BelaPlatform/bela-pepper/README.md

# PEPPER

Pepper is a DIY solution for integrating Bela with modular and Eurorack synths. [Click here](https://github.com/BelaPlatform/bela-pepper/wiki) for more information.
