BelaPlatform/bela-pepper/Design Files/renders/PCB/pepper-bottom.jpg

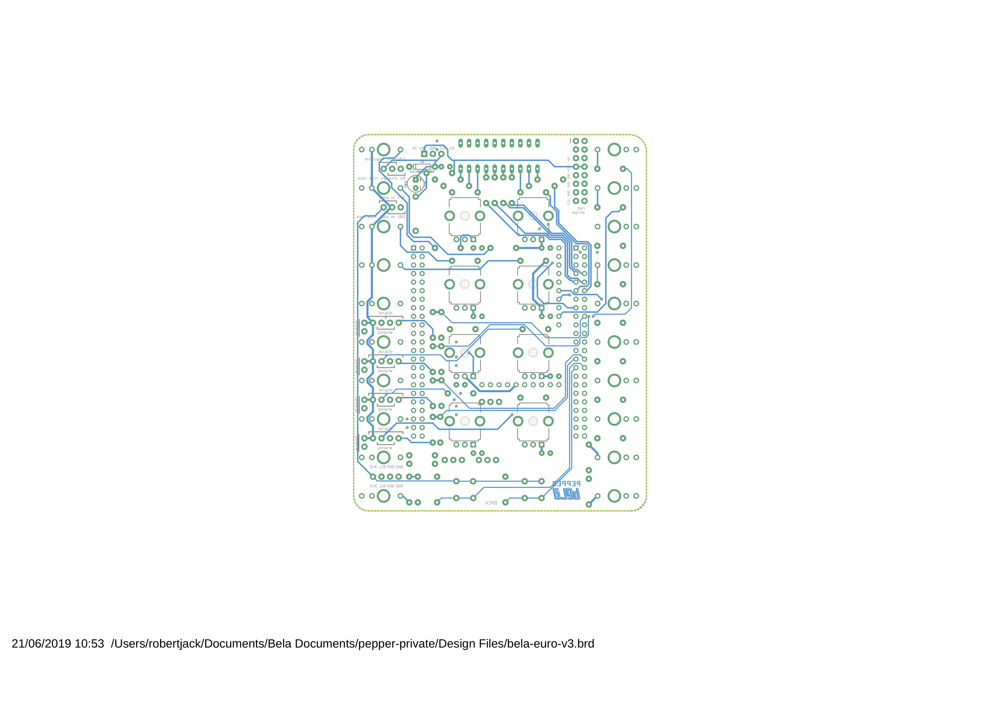
Design Files/renders/PCB/pepper-bottom.jpg
