BelaPlatform/bela-pepper/Design Files/renders/Schematic/pepper-rev2b-schematic.png

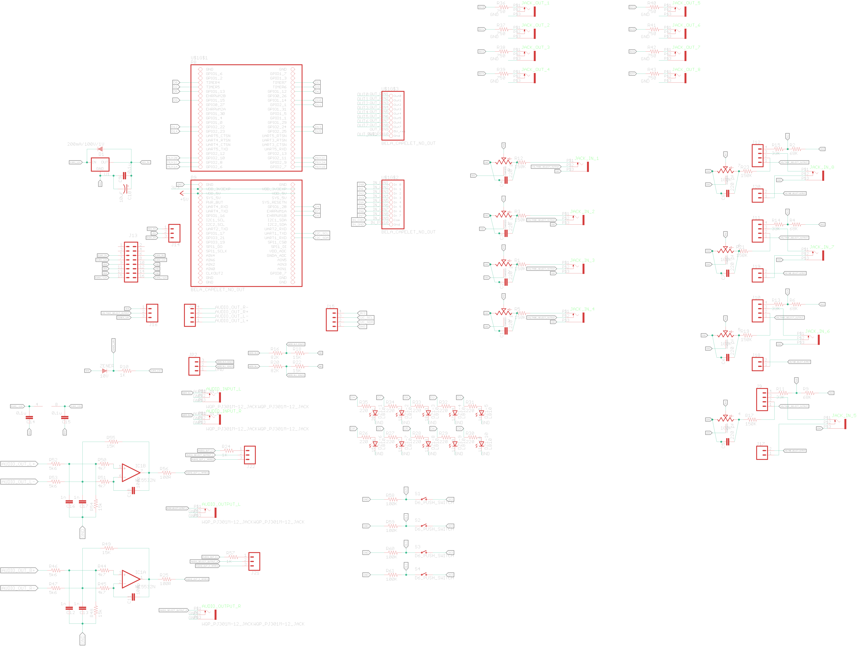
Design Files/renders/Schematic/pepper-rev2b-schematic.png
