BelaPlatform/bela-pepper/Design Files/renders/Schematic/pepper-schematic.jpg

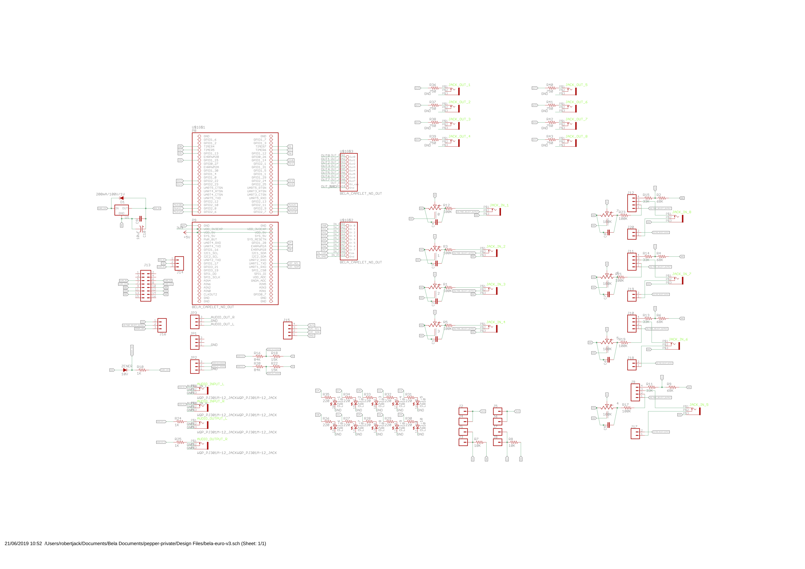
Design Files/renders/Schematic/pepper-schematic.jpg
