BelaPlatform/bela-pepper/(threads)

Thread 1 (2020-03-04):

Pepper build suggestion

ilionic, 2020-03-04:
Recently finished the build but got step 11. wrong - attaching LED bar graph upside down.
That was quite challenging component to desolder and replace ( ended up ordering new one ).
Perhaps worth adding a note for beginners like me to make sure LED bar graph text and cut corner should be facing downwards.
Thanks

giuliomoro, 2020-04-28:
@roberthjack ?

roberthjack, 2020-04-29:
Closed #1.

On Wed, Apr 29, 2020 at 12:34 AM giuliomoro <notifications@github.com>
wrote:

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

bengarland, 2020-07-12:
> That was quite challenging component to desolder and replace ( ended up ordering new one ).

I recently got a Hakko FR-301 desoldering gun and it has been a lifesaver. I thought I'd rarely use it, but it has paid for itself in less than a month. Highly recommended... I can't believe I went so long without one.

ilionic, 2020-07-13:
> I recently got a Hakko FR-301 desoldering gun and it has been a lifesaver. I thought I'd rarely use it, but it has paid for itself in less than a month. Highly recommended... I can't believe I went so long without one.

Nice one, I am pretty sure Hakko doing great job here but need to justify such investment if you are desoldering lots of multi pin components.

Closed 2020-07-31.

Thread 2 (2020-07-12):

Building Rev 2, Step 24 shows erroneous pic?

bengarland, 2020-07-12:
Building Rev 2, Step 24 says "add the female header to the line output to the Bela cape" which should be a 4-pin but the pic shows a 3-pin header. I suggest clarifying this step to say "add the 4-pin female header to the line output to the Bela cape" and show the correct pic.

PS I also added some comments to the BOM, in case it doesn't automatically notify you about it.

Closed 2020-07-31.

Thread 3 (2021-01-02):

Turn off Pepper

FriendlyBalint, 2021-01-02:
If I put Pepper into my eurorack case and I can't push the off button on Bela how can I turn off Bela properly?

giuliomoro, 2021-01-03:
Graceful shutdown of the board is only critical when you have been editing code / building programs. In case of "headless" use, where you don't write to disk, you can just unplug the power from the rack.

Closed 2021-01-03.

Thread 4 (2021-08-10):

USB connection using breakout panel

vsandstrom, 2021-08-10:
In the build kit there is the panel for usb host and device. I thought there would be some easy access solder points or some pins that can be configured as usb on the beaglebone, but I cannot find that info anywhere.

I haven't found any documentation of how to install these ports either, and I am wondering if there is a method or if it is supposed to just be some kind of extension cables.

Anyway, would mean a lot easier access to programming the device when implemented rather than inserting it removing it from the case every time you need to debug a new patch.

roberthjack, 2021-08-10:
There are no solder points as such rather we use standard USB panel mount extension cables with a right angle connector for the board. There are some links as part of the build guide with recommended parts for both the host and device. You can find them here: https://github.com/BelaPlatform/bela-pepper/wiki/Bill-of-Materials#usb-breakout

There are a few different suppliers depending on where you are based. Hope that helps.

Closed 2022-05-25.

Thread 8 (2022-08-13):

Digital In/Out documentation

vsandstrom, 2022-08-13:
I am trying to find somewhere where the segment display and the buttons have their inputs/outputs documented. I am going through the DSP C++ coursework on YouTube and have difficulty using the digital I/O because nothing seems to correspond to what I think it does.

Is there an official documentation of Pepper-specific mapping of digital I/O?

giuliomoro, 2022-08-13:
the pinout of those pins can be found [here](https://github.com/BelaPlatform/bela-pepper/wiki/Pin-numbering)

Closed 2022-08-13.

Thread 10 (2022-09-12):

Connections for Illuminated Buttons

roberthjack, 2022-09-12:
This would be an optional extra if using illuminated LEDs, like in the Befaco DIY kits. The LEDs would be hardwired to the button or to the state of the inputs coming in through the trigger inputs. Extra protection resistor would be necessary between 3v3 and the LEDs.

Thread 9 (2022-09-12):

Switch Power Header for 10-pin

roberthjack, 2022-09-12:
This will require removing the corresponding 5V configuration pin.

giuliomoro, 2023-01-15:
Or leave it 16 pin but ship the correct one

Thread 11 (2022-12-14):

Wiki Schematics and PCB rev2 links are broken

x37v, 2022-12-14:
The links here:

https://github.com/BelaPlatform/bela-pepper/wiki/Schematics-and-PCB

Thread 12 (2023-01-16):

Diagnostics project

roberthjack, 2023-01-16:
Create a project which can be run once the build is complete to test everything is working.

Loop back all outputs to inputs, CV and Audio. Cycle through LEDS. Print reading from buttons. For example of loop back code see the bela cape test: [ ](https://github.com/BelaPlatform/Bela/tree/master/examples/Extras/cape-test)

giuliomoro, 2023-01-16:
Extras/salt-factory-taste could also be useful.
