BelaPlatform/bela-pepper/Design Files/renders/Faceplate/pepper_faceplate_rev2.pdf

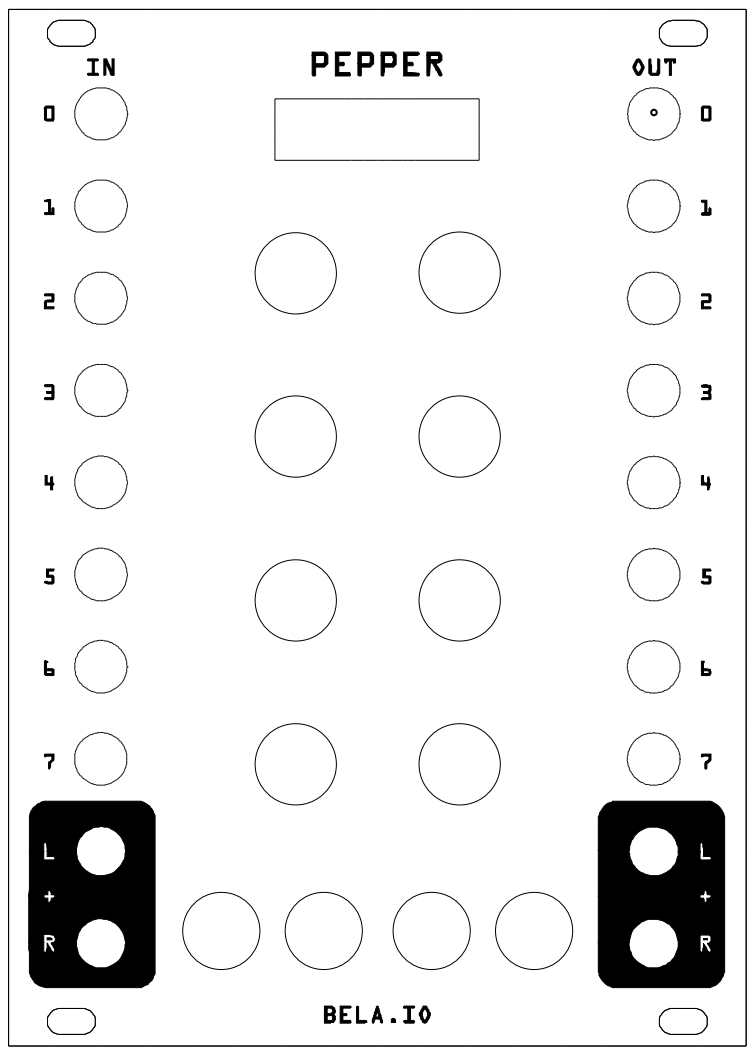
[picture p4: page 1]

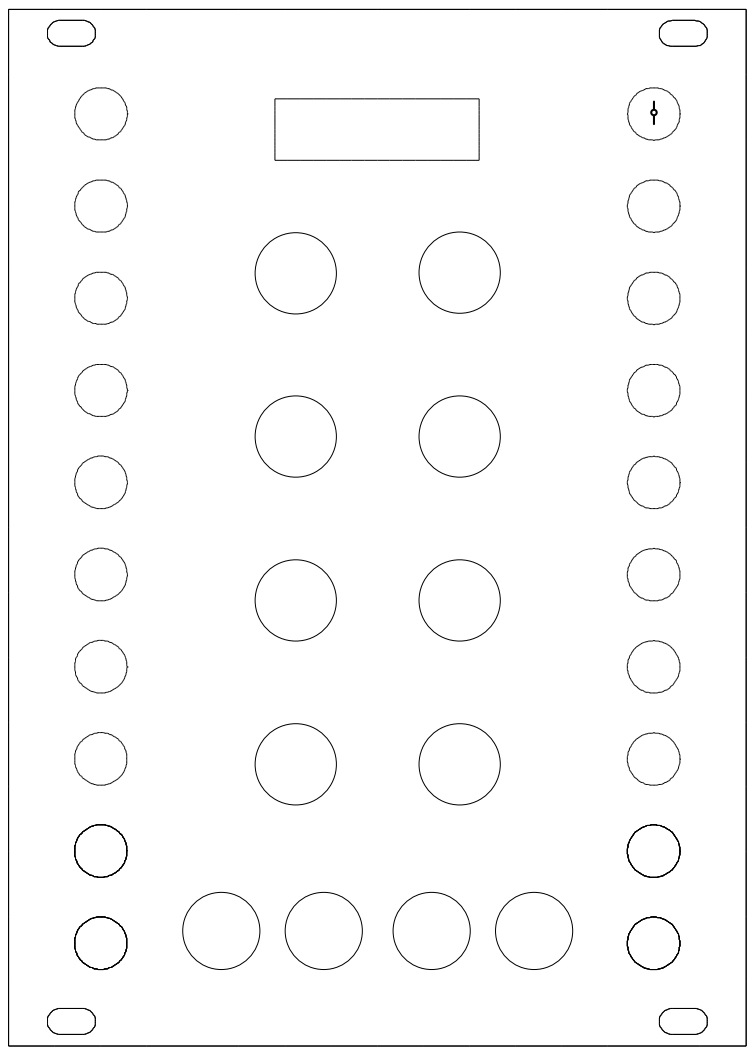
[picture p5: page 2]

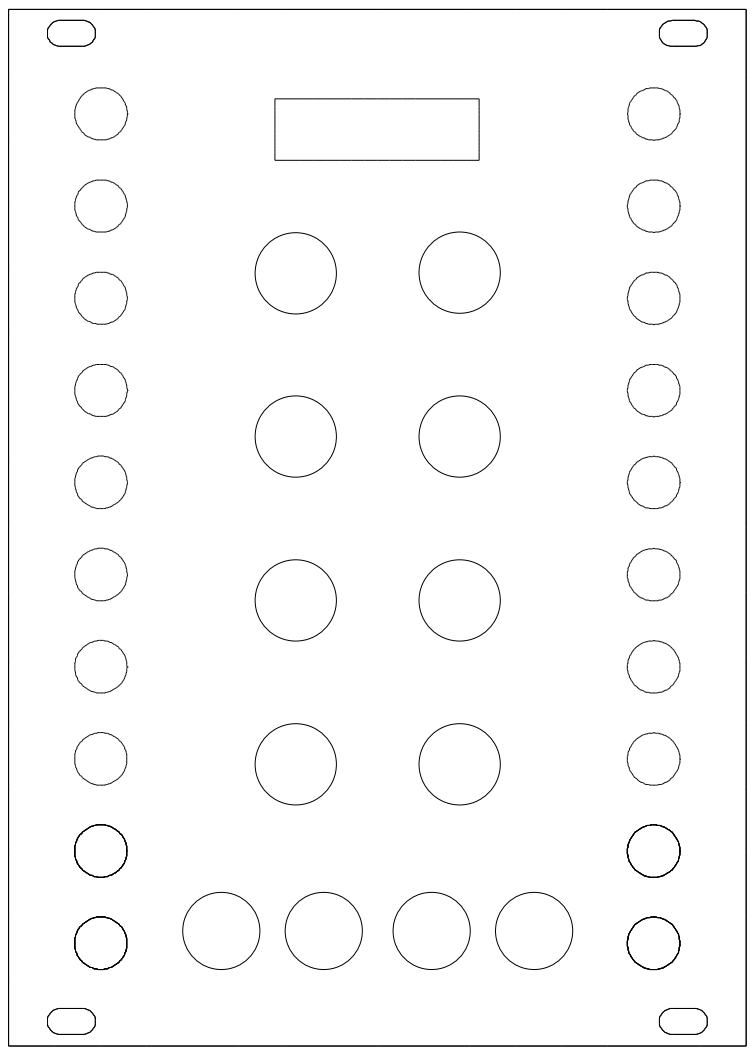
[picture p6: page 3]

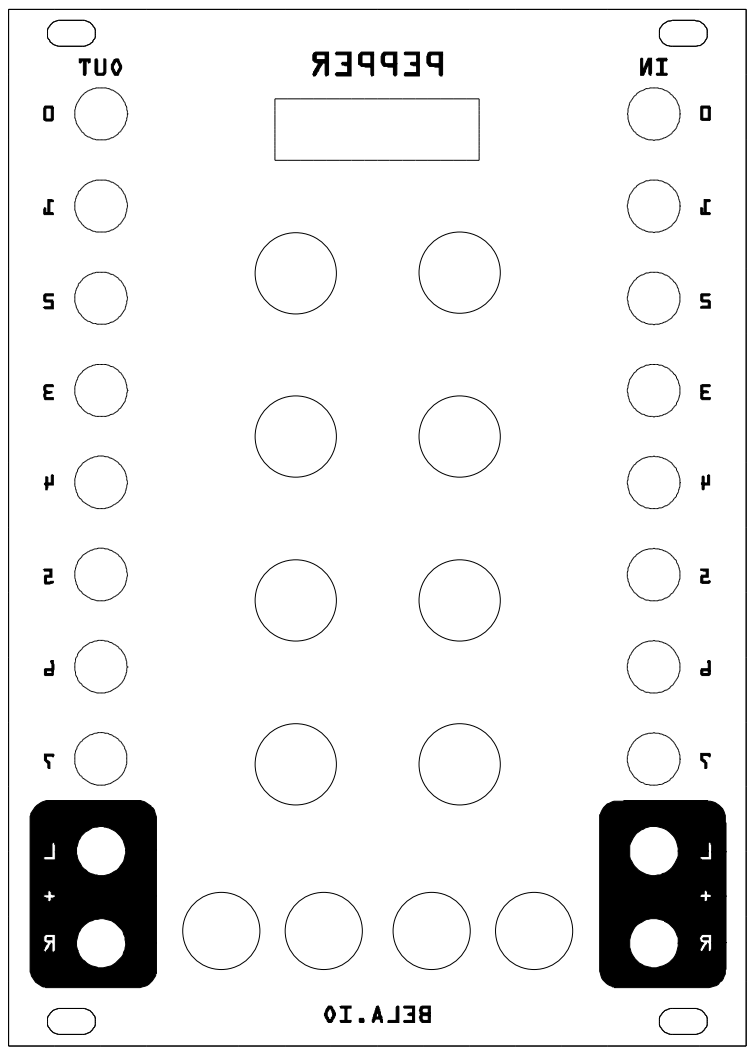
[picture p7: page 6]

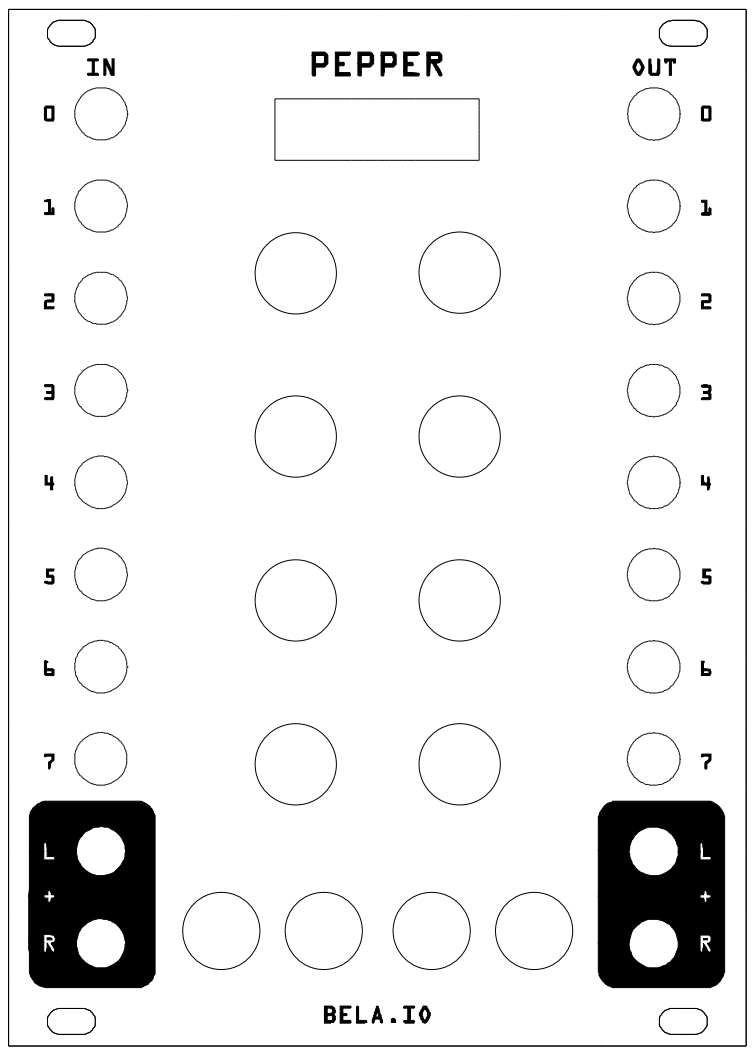
[picture p8: page 7]

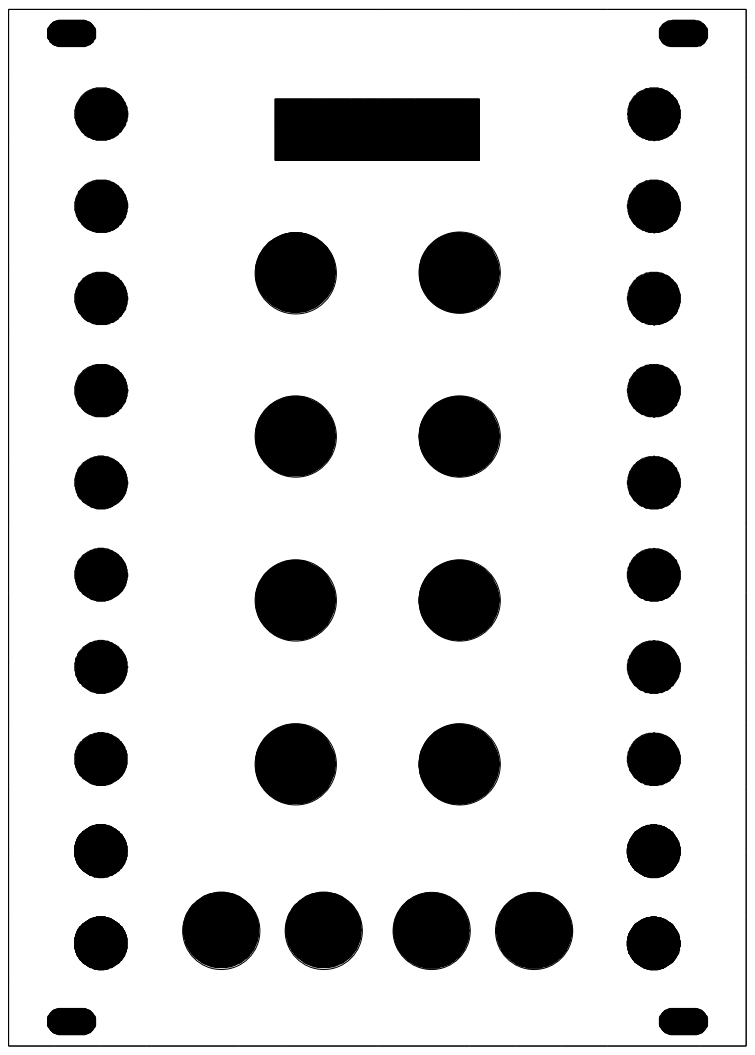
[picture p9: page 8]
