BelaPlatform/bela-pepper/Design Files/renders/PCB/pepper-rev2b.brd.pdf

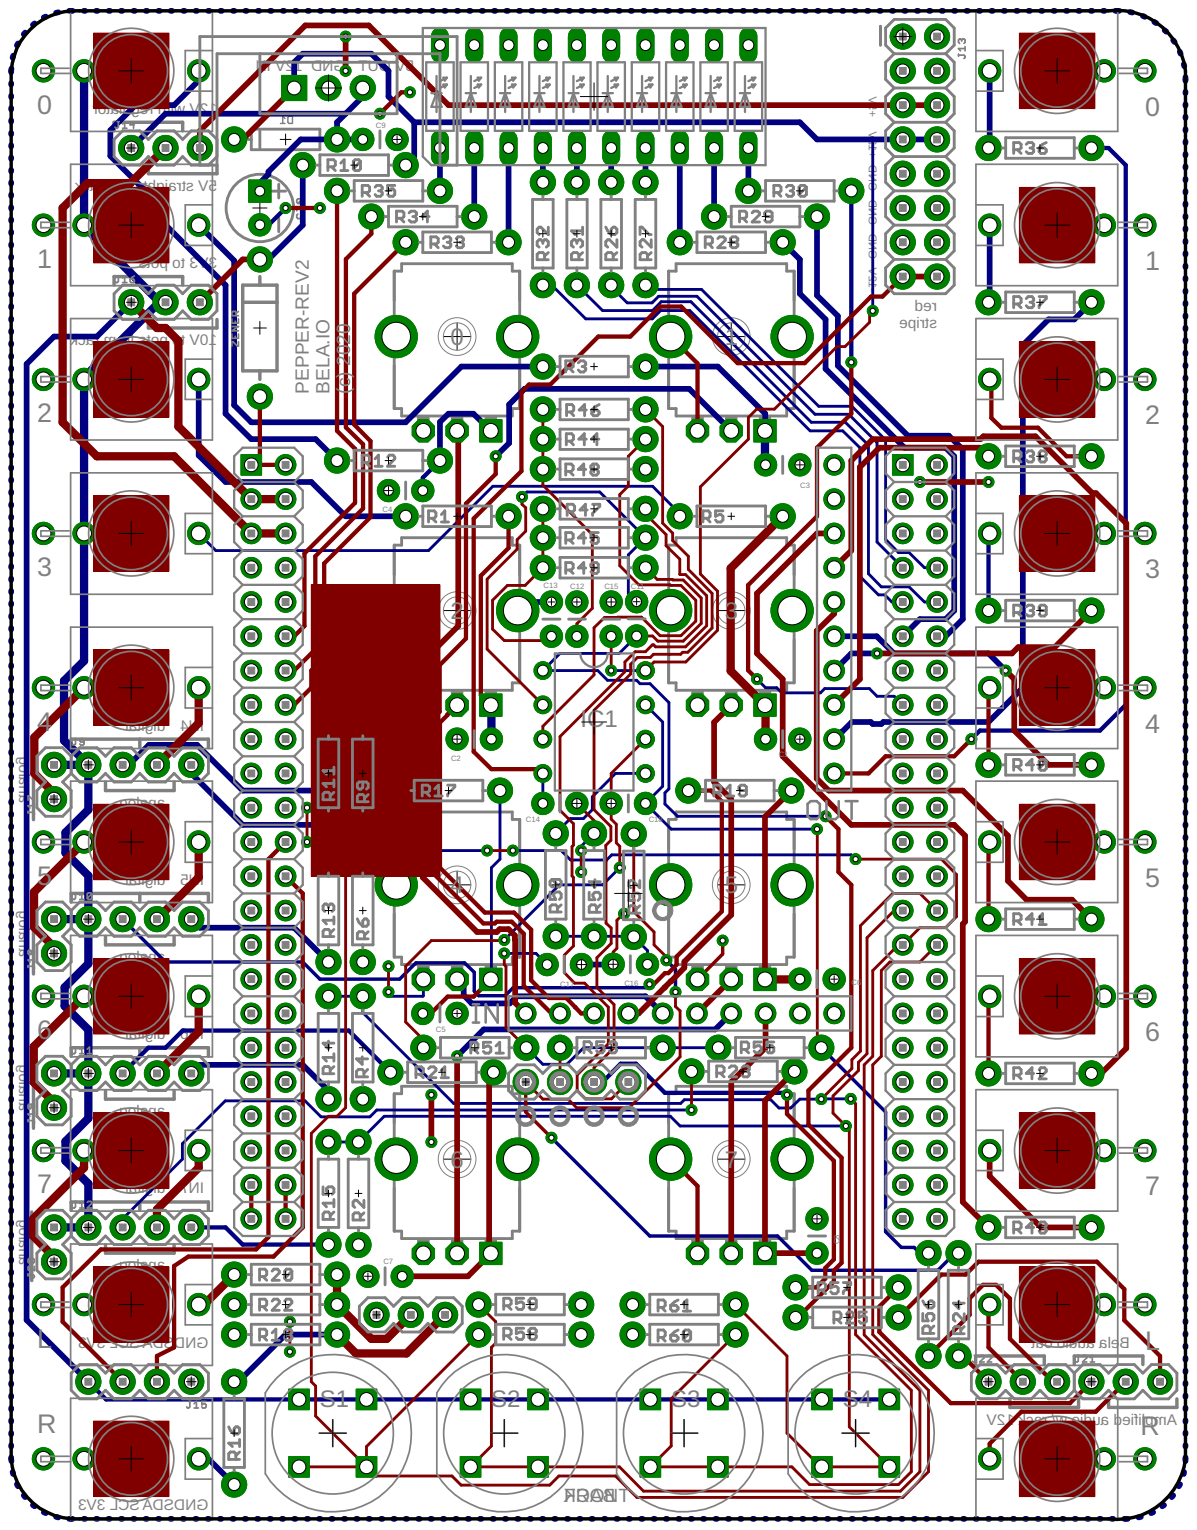
[picture p10: page 1]

analog analog
