BelaPlatform/bela-pepper/Design Files/renders/Faceplate/pepper-faceplate-rev1.pdf

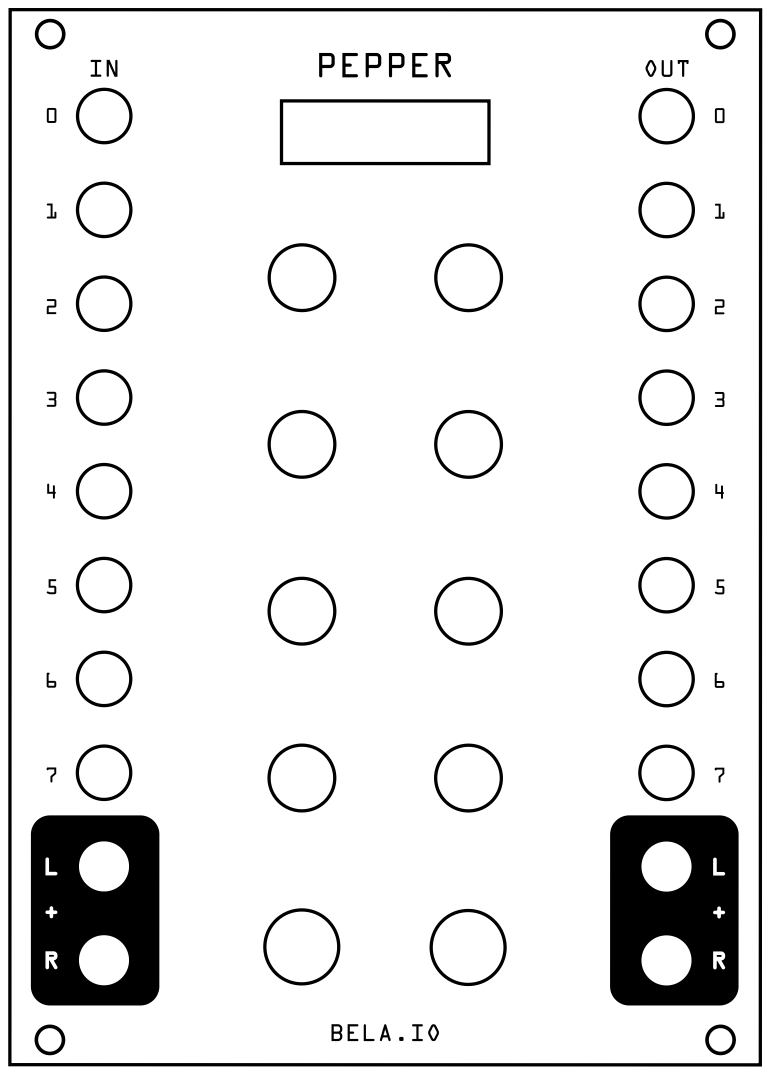
[picture p11: page 1]
