BelaPlatform/bela-pepper/Design Files/rev2/pepper-rev2.brd

## EAGLE design Design Files/rev2/pepper-rev2.brd (2022-09-14)

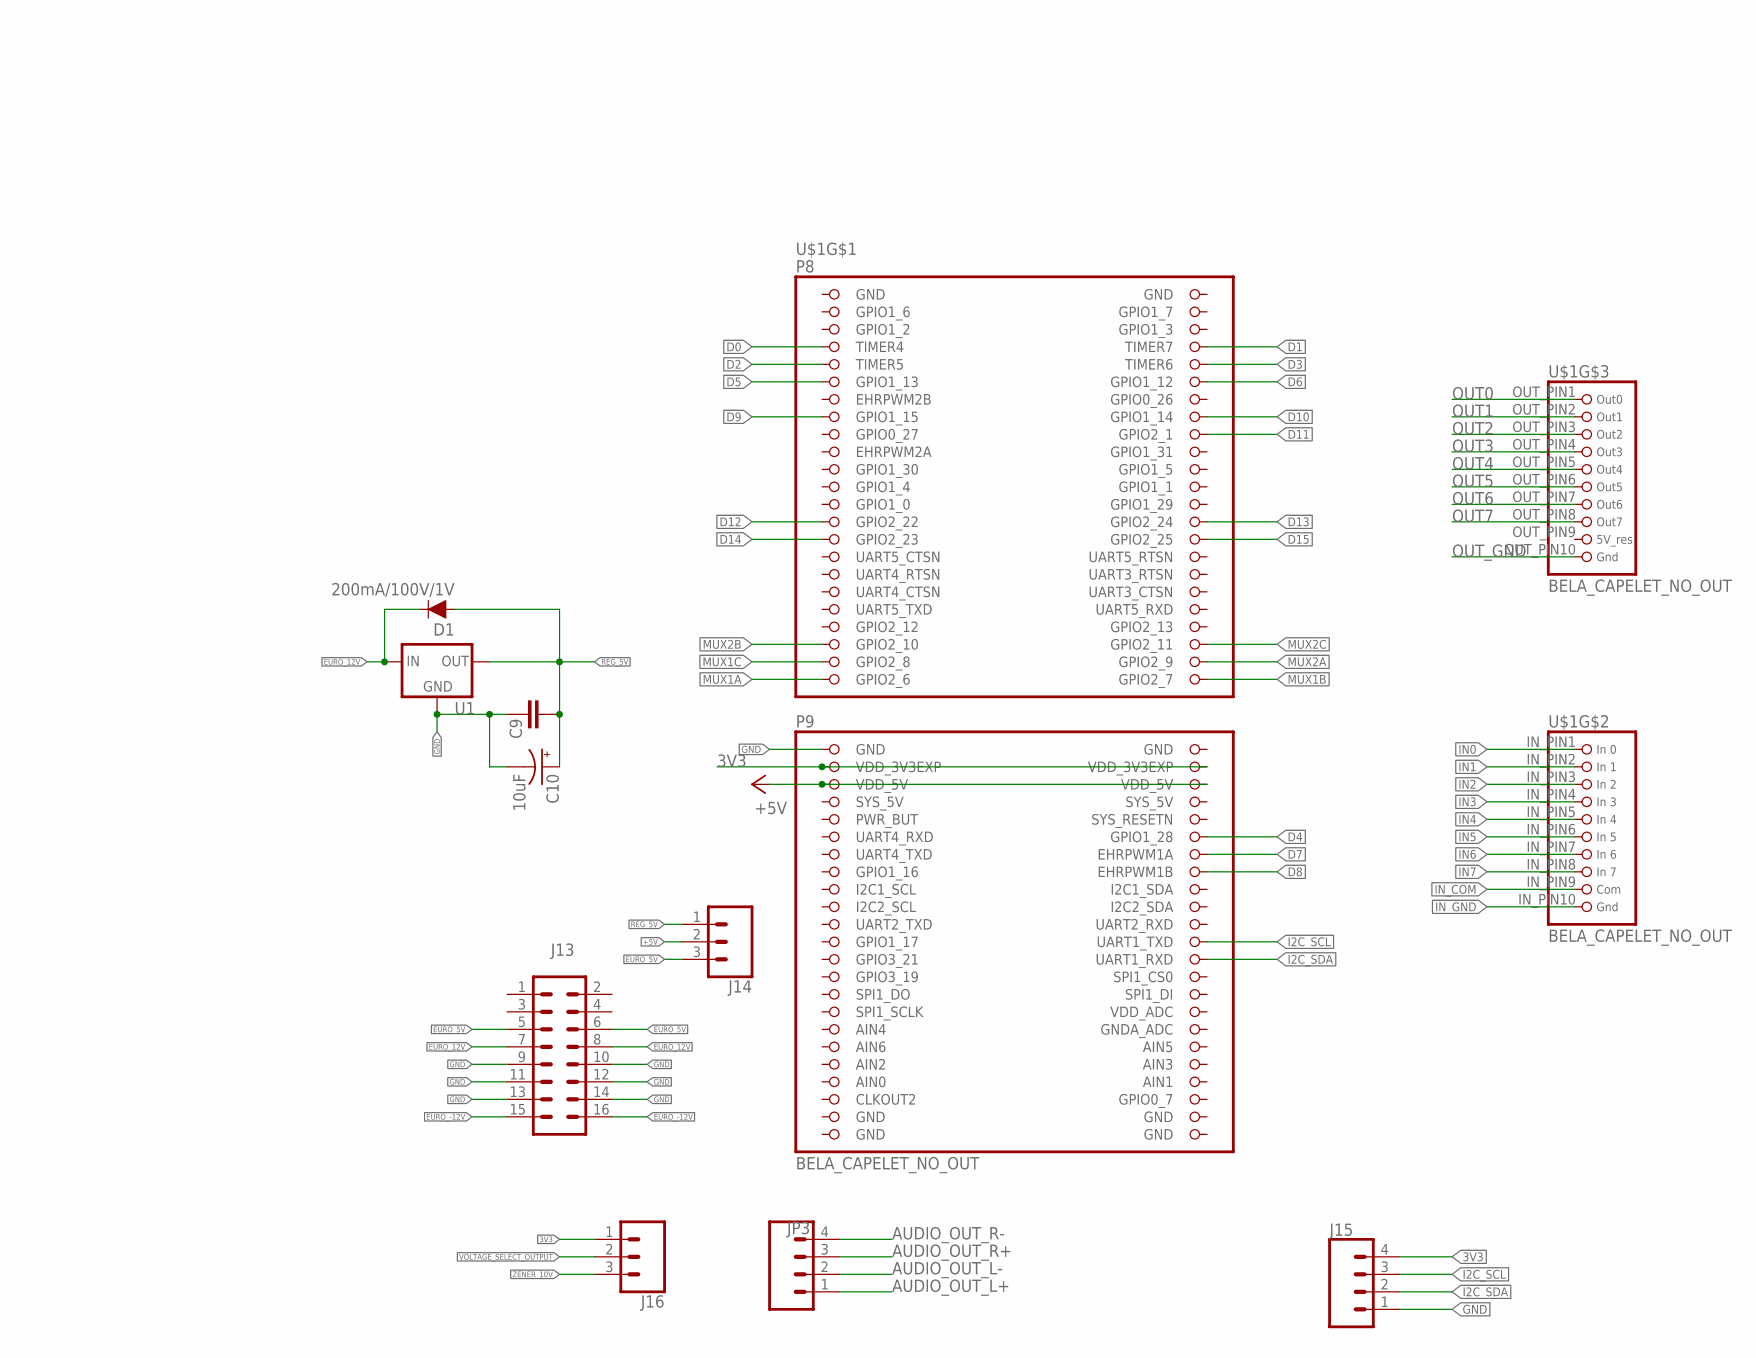
[picture p12: schematic pepper-rev2.sch, part in row 1, column 1]

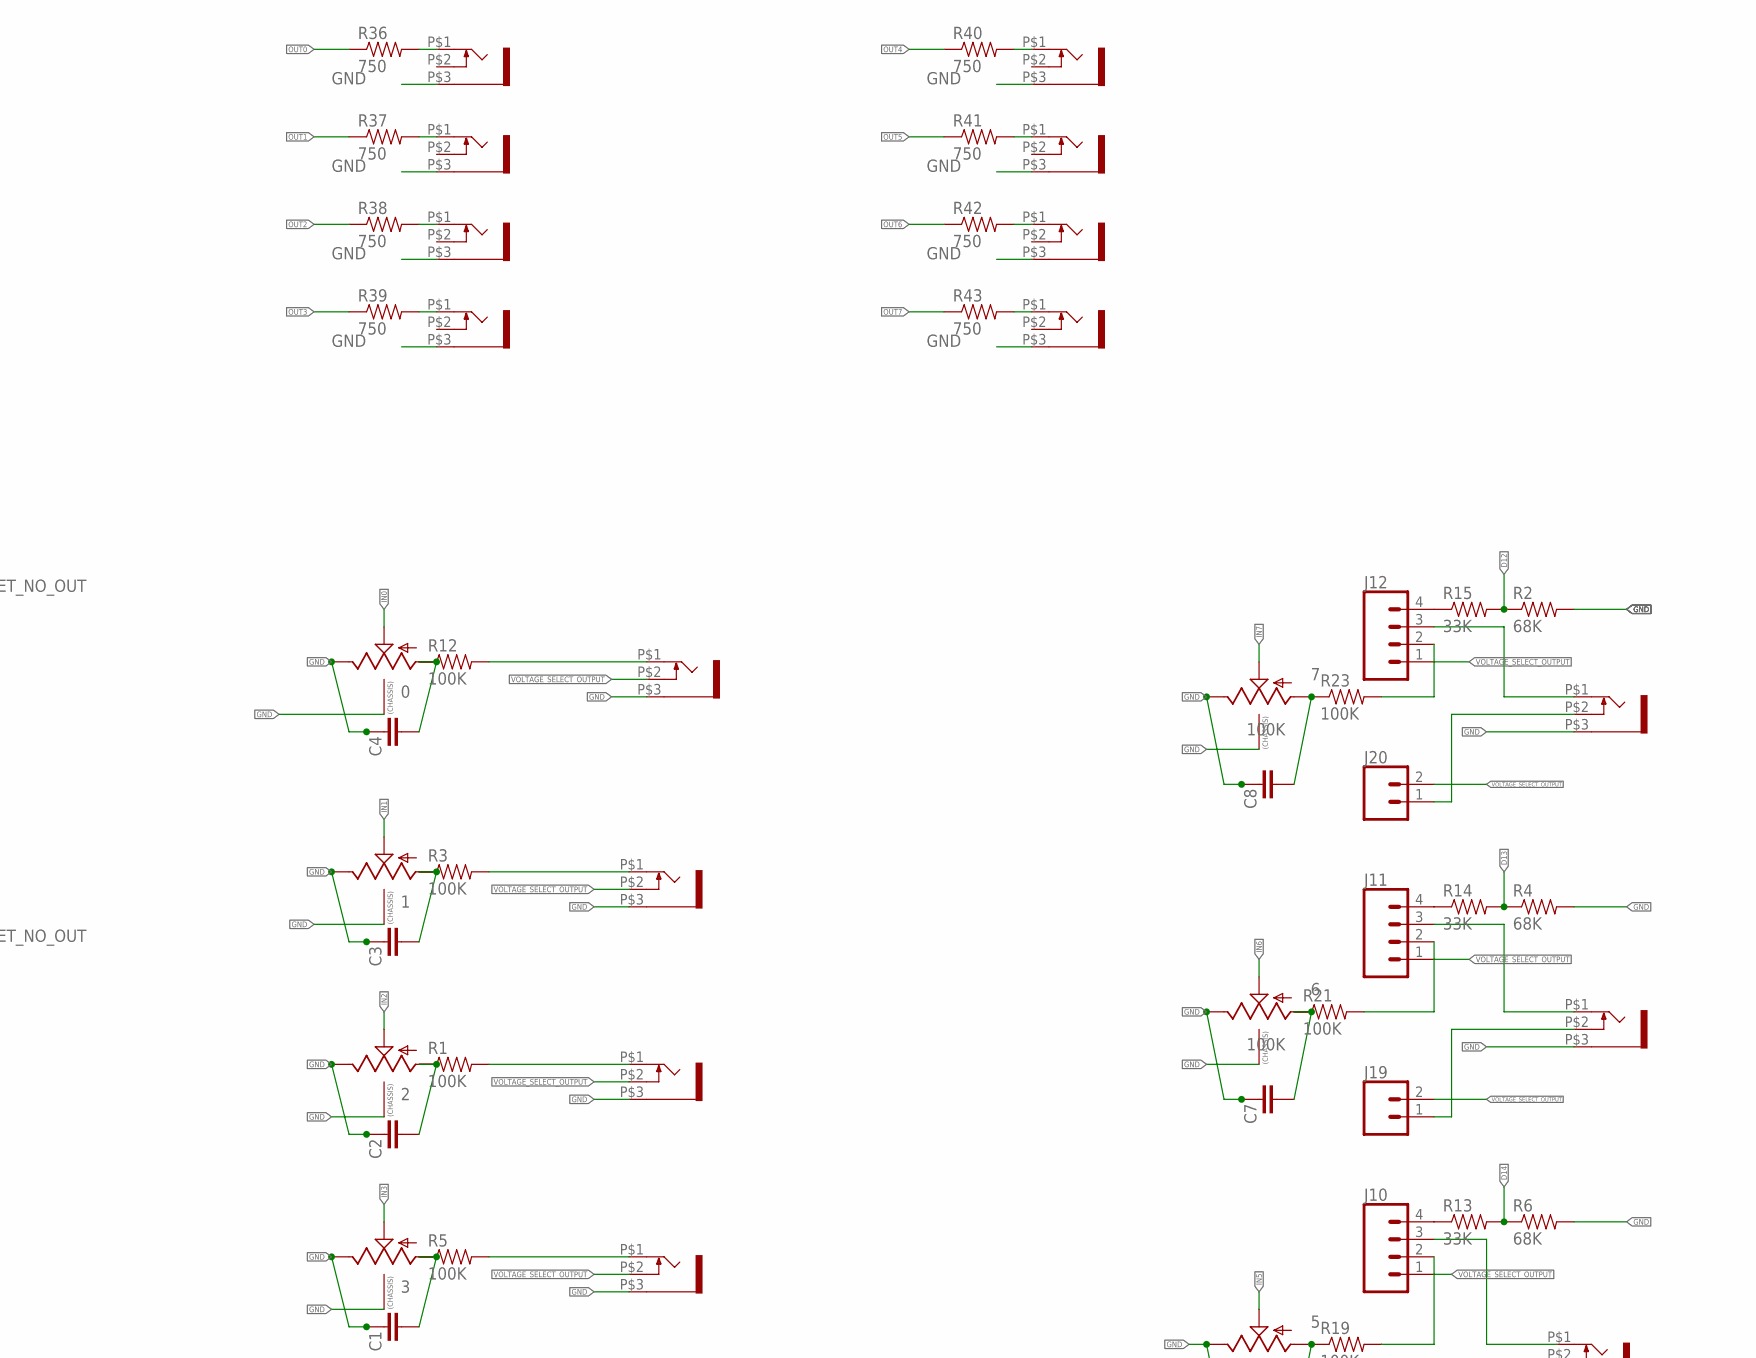
[picture p13: schematic pepper-rev2.sch, part in row 1, column 2]

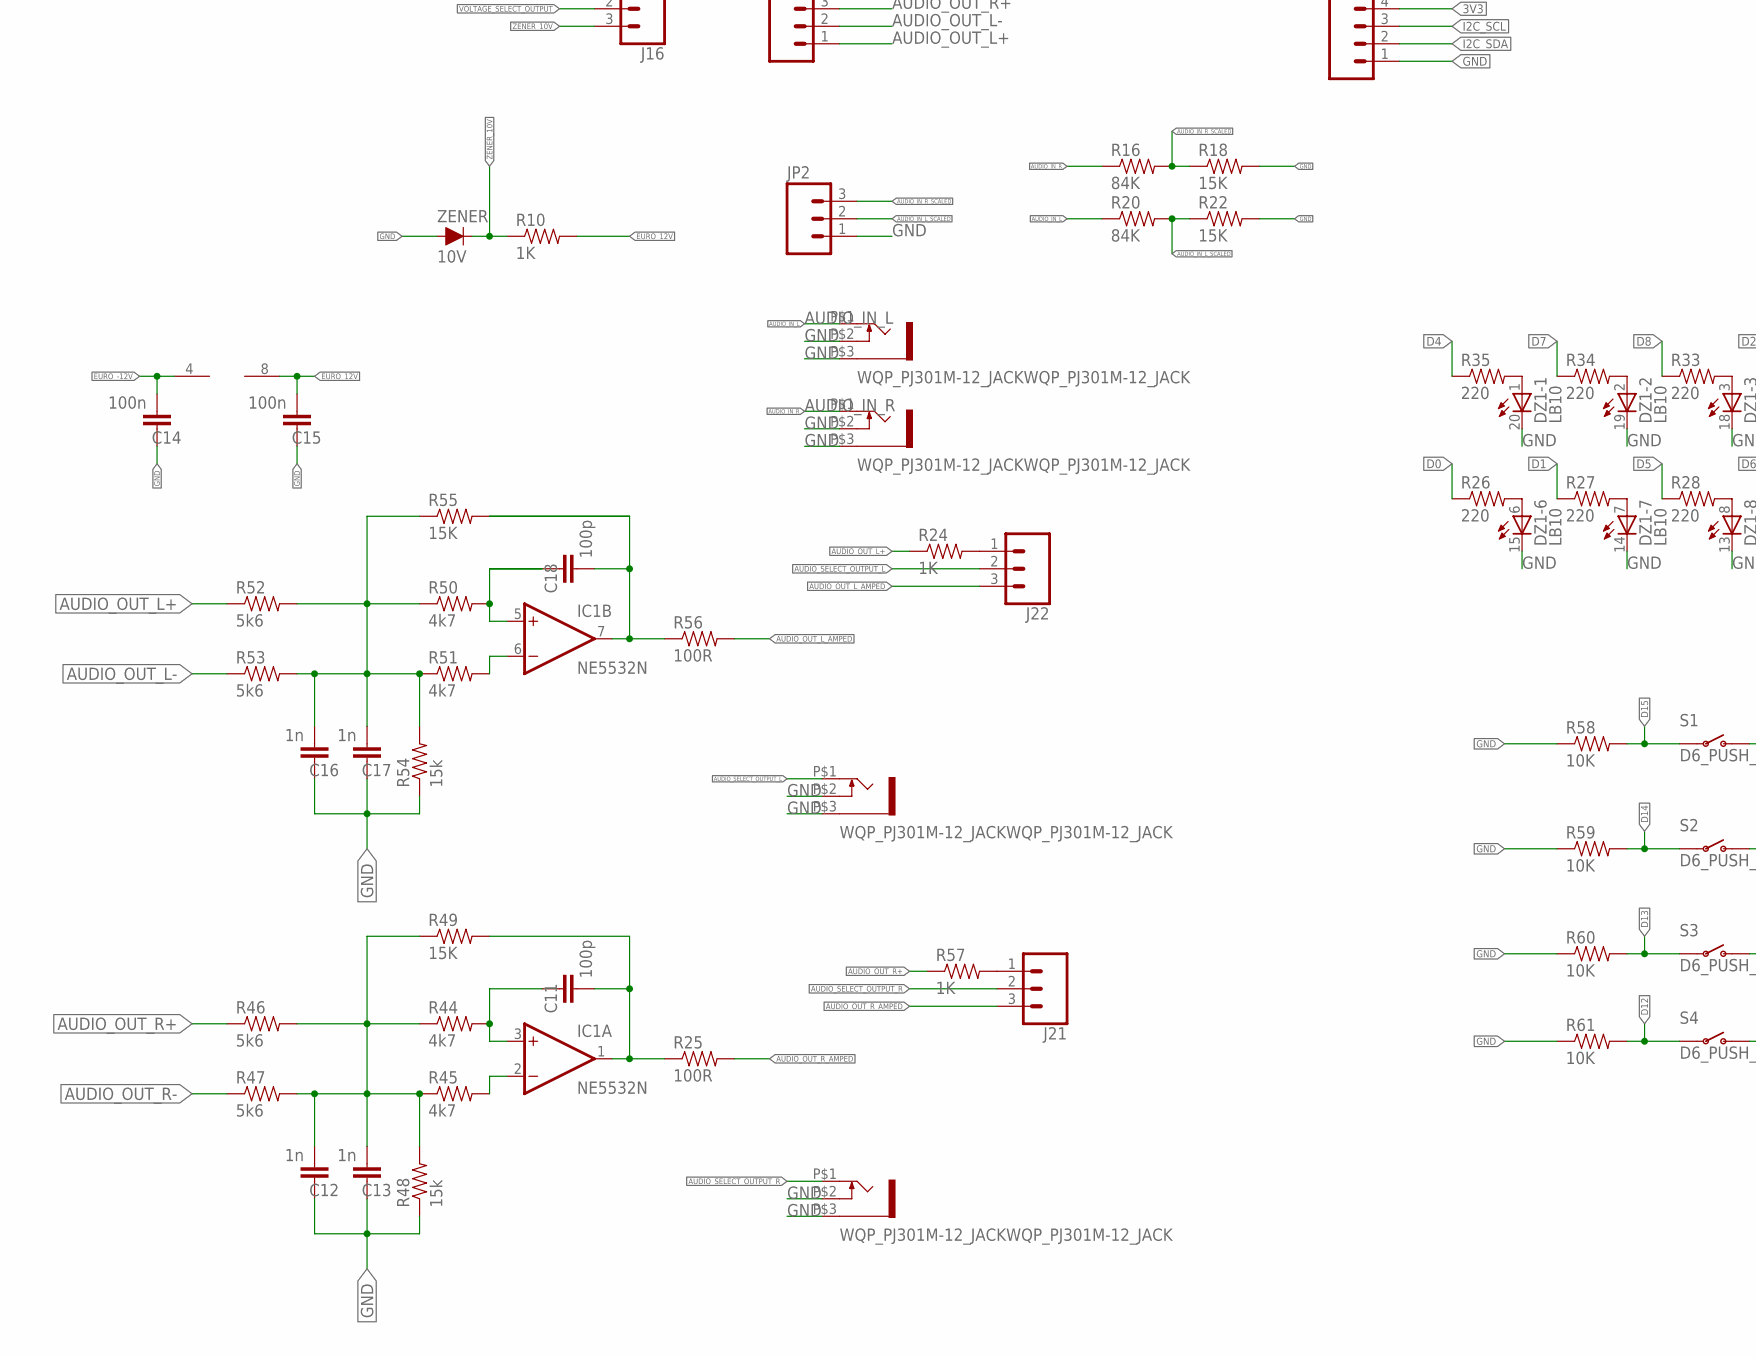
[picture p14: schematic pepper-rev2.sch, part in row 2, column 1]

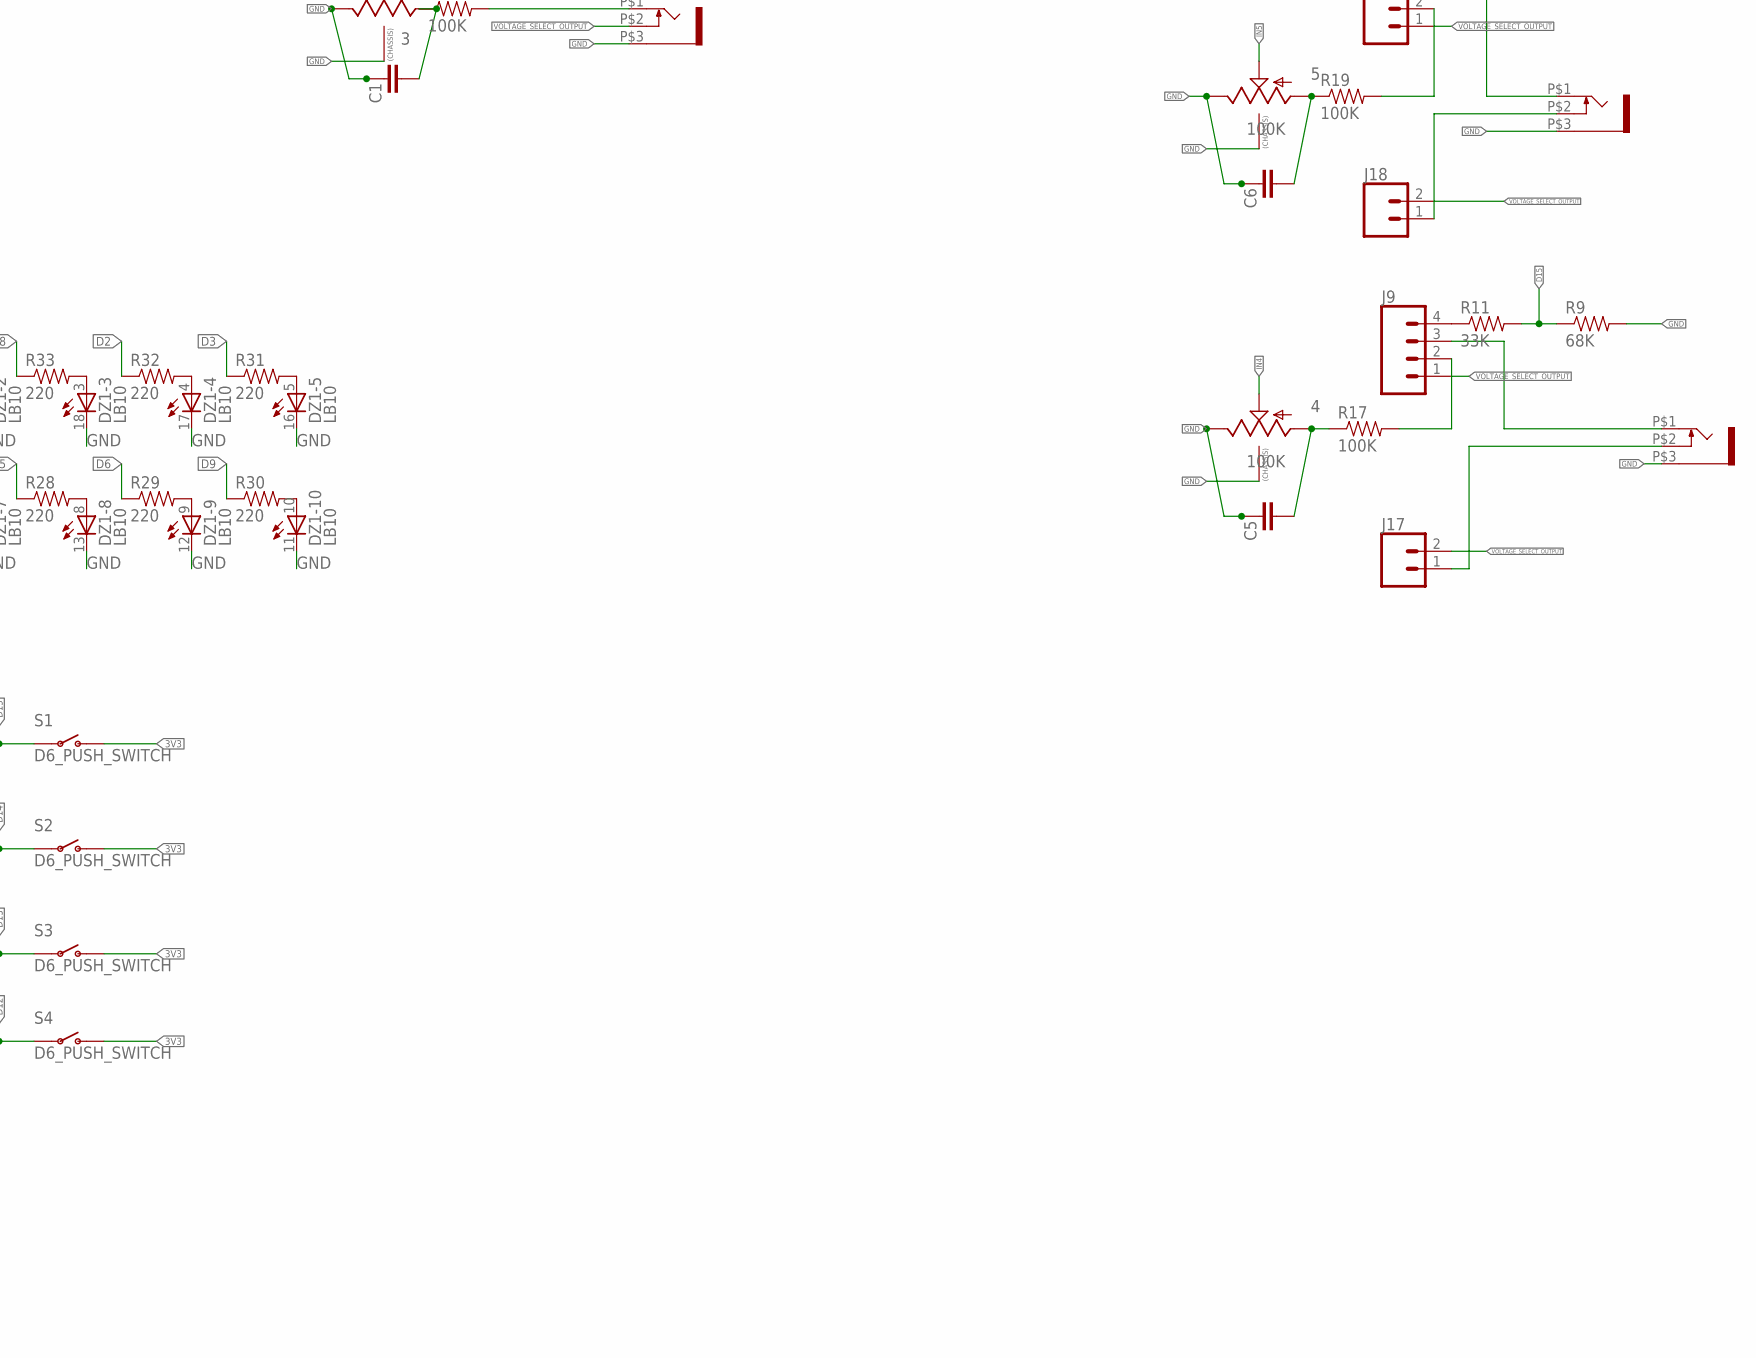
[picture p15: schematic pepper-rev2.sch, part in row 2, column 2]

Parts:
0, 1, 2, 3: 9MM_SNAP-IN_POT_CHASSIS; 9MM_SNAP-IN_POT
4, 5, 6, 7: 100K; 9MM_SNAP-IN_POT
AUDIO_INPUT_L: WQP_PJ301M-12_JACKWQP_PJ301M-12_JACK; JACK-3.5
AUDIO_INPUT_R: WQP_PJ301M-12_JACKWQP_PJ301M-12_JACK; JACK-3.5
AUDIO_OUTPUT_L: WQP_PJ301M-12_JACKWQP_PJ301M-12_JACK; JACK-3.5
AUDIO_OUTPUT_R: WQP_PJ301M-12_JACKWQP_PJ301M-12_JACK; JACK-3.5
C1, C2, C3, C4, C5, C6, C7, C8, C9: CAPPTH; CAP-PTH-SMALL
C10: 10uF; CPOL-RADIAL-2.5MM-5MM
C11, C18: 100p; CAP-PTH-SMALL
C12, C13, C16, C17: 1n; CAP-PTH-SMALL
C14, C15: 100n; CAP-PTH-SMALL
D1: 200mA/100V/1V; DIODE-1N4148
DZ1: LB10
IC1: NE5532N; DIL08
J9, J10, J11, J12, J15: CONN_04PTH; 1X04
J13: 2X6 FEMALE; 2X8
J14, J16, J21, J22: CONN_03; 1X03
J17, J18, J19, J20: CONN_02; 1X02
JACK_IN_1, JACK_IN_2, JACK_IN_3, JACK_IN_4, JACK_IN_5, JACK_IN_6, JACK_IN_7, JACK_IN_8: WQP_PJ301M-12_JACKWQP_PJ301M-12_JACK; JACK-3.5
JACK_OUT_1, JACK_OUT_2, JACK_OUT_3, JACK_OUT_4, JACK_OUT_5, JACK_OUT_6, JACK_OUT_7, JACK_OUT_8: WQP_PJ301M-12_JACKWQP_PJ301M-12_JACK; JACK-3.5
JP2: M03PTH; 1X03@1
JP3: CONN_04; 1X04
R1, R3, R5, R12, R17, R19, R21, R23: 100K; AXIAL-0.3
R2, R4, R6, R9: 68K; AXIAL-0.3
R10, R24, R57: 1K; AXIAL-0.3
R11, R13, R14, R15: 33K; AXIAL-0.3
R16, R20: 84K; AXIAL-0.3
R18, R22, R49, R55: 15K; AXIAL-0.3
R25, R56: 100R; AXIAL-0.3
R26, R27, R28, R29, R30, R31, R32, R33, R34, R35: 220; AXIAL-0.3
R36, R37, R38, R39, R40, R41, R42, R43: 750; AXIAL-0.3
R44, R45, R50, R51: 4k7; AXIAL-0.3
R46, R47, R52, R53: 5k6; AXIAL-0.3
R48, R54: 15k; AXIAL-0.3
R58, R59, R60, R61: 10K; AXIAL-0.3
S1, S2, S3, S4: D6_PUSH_SWITCH
U1: V_REG_78XXSINK; TO220-IGO
U$1: BELA_CAPELET_NO_OUT; BELA_CAPELET_NO_OUTLINE
ZENER: 10V; DIODE-1N4001-KIT

Connections:
1: JACK_IN_3.P$1 (2), R1.P$2 (2)
2: JACK_IN_2.P$1 (2), R3.P$2 (2)
3: JACK_IN_1.P$1 (2), R12.P$2 (2)
3V3: J15.4, J16.1, S1.P$1 (O), S1.P$2 (O), S2.P$1 (O), S2.P$2 (O), S3.P$1 (O), S3.P$2 (O), S4.P$1 (O), S4.P$2 (O), U$1.49 (VDD_3V3EXP), U$1.50 (VDD_3V3EXP)
4: JACK_IN_4.P$1 (2), R5.P$2 (2)
+5V: J14.2, U$1.51 (VDD_5V), U$1.52 (VDD_5V)
AIN0: U$1.85 (AIN0)
AUDIO_IN_L: AUDIO_INPUT_L.P$1 (2), R20.P$1 (1)
AUDIO_IN_L_SCALED: JP2.2, R20.P$2 (2), R22.P$1 (1)
AUDIO_IN_R: AUDIO_INPUT_R.P$1 (2), R16.P$1 (1)
AUDIO_IN_R_SCALED: JP2.3, R16.P$2 (2), R18.P$1 (1)
AUDIO_OUT_L+: JP3.1, R24.P$1 (1), R52.P$1 (1)
AUDIO_OUT_L-: JP3.2, R53.P$1 (1)
AUDIO_OUT_L_AMPED: J22.3, R56.P$2 (2)
AUDIO_OUT_R+: JP3.3, R46.P$1 (1), R57.P$1 (1)
AUDIO_OUT_R-: JP3.4, R47.P$1 (1)
AUDIO_OUT_R_AMPED: J21.3, R25.P$2 (2)
AUDIO_SELECT_OUTPUT_L: AUDIO_OUTPUT_L.P$1 (2), J22.2
AUDIO_SELECT_OUTPUT_R: AUDIO_OUTPUT_R.P$1 (2), J21.2
D0: R26.P$1 (1), U$1.7 (TIMER4)
D1: R27.P$1 (1), U$1.8 (TIMER7)
D2: R32.P$1 (1), U$1.9 (TIMER5)
D3: R31.P$1 (1), U$1.10 (TIMER6)
D4: R35.P$1 (1), U$1.58 (GPIO1_28)
D5: R28.P$1 (1), U$1.11 (GPIO1_13)
D6: R29.P$1 (1), U$1.12 (GPIO1_12)
D7: R34.P$1 (1), U$1.60 (EHRPWM1A)
D8: R33.P$1 (1), U$1.62 (EHRPWM1B)
D9: R30.P$1 (1), U$1.15 (GPIO1_15)
D10: U$1.16 (GPIO1_14)
D11: U$1.18 (GPIO2_1)
D12: R2.P$1 (1), R15.P$2 (2), R61.P$2 (2), S4.P$3, S4.P$4, U$1.27 (GPIO2_22)
D13: R4.P$1 (1), R14.P$2 (2), R60.P$2 (2), S3.P$3, S3.P$4, U$1.28 (GPIO2_24)
D14: R6.P$1 (1), R13.P$2 (2), R59.P$2 (2), S2.P$3, S2.P$4, U$1.29 (GPIO2_23)
D15: R9.P$1 (1), R11.P$2 (2), R58.P$2 (2), S1.P$3, S1.P$4, U$1.30 (GPIO2_25)
EURO_5V: J13.5, J13.6, J14.3
EURO_12V: C15.2, D1.C, IC1.8 (V+), J13.7, J13.8, R10.P$2 (2), U1.IN
EURO_-12V: C14.2, IC1.4 (V-), J13.15, J13.16
GND: 0.3 (E), 0.CHASSIS1, 0.CHASSIS2, 1.3 (E), 1.CHASSIS1, 1.CHASSIS2, 2.3 (E), 2.CHASSIS1, 2.CHASSIS2, 3.3 (E), 3.CHASSIS1, 3.CHASSIS2, 4.3 (E), 4.CHASSIS1, 4.CHASSIS2, 5.3 (E), 5.CHASSIS1, 5.CHASSIS2, 6.3 (E), 6.CHASSIS1, 6.CHASSIS2, 7.3 (E), 7.CHASSIS1, 7.CHASSIS2, AUDIO_INPUT_L.P$2 (3), AUDIO_INPUT_L.P$3 (1), AUDIO_INPUT_R.P$2 (3), AUDIO_INPUT_R.P$3 (1), AUDIO_OUTPUT_L.P$2 (3), AUDIO_OUTPUT_L.P$3 (1), AUDIO_OUTPUT_R.P$2 (3), AUDIO_OUTPUT_R.P$3 (1), C1.1, C2.1, C3.1, C4.1, C5.1, C6.1, C7.1, C8.1, C9.1, C10.2 (-), C12.1, C13.1, C14.1, C15.1, C16.1, C17.1, DZ1.11 (C), DZ1.12 (C), DZ1.13 (C), DZ1.14 (C), DZ1.15 (C), DZ1.16 (C), DZ1.17 (C), DZ1.18 (C), DZ1.19 (C), DZ1.20 (C), J13.9, J13.10, J13.11, J13.12, J13.13, J13.14, J15.1, JACK_IN_1.P$3 (1), JACK_IN_2.P$3 (1), JACK_IN_3.P$3 (1), JACK_IN_4.P$3 (1), JACK_IN_5.P$3 (1), JACK_IN_6.P$3 (1), JACK_IN_7.P$3 (1), JACK_IN_8.P$3 (1), JACK_OUT_1.P$3 (1), JACK_OUT_2.P$3 (1), JACK_OUT_3.P$3 (1), JACK_OUT_4.P$3 (1), JACK_OUT_5.P$3 (1), JACK_OUT_6.P$3 (1), JACK_OUT_7.P$3 (1), JACK_OUT_8.P$3 (1), JP2.1, R2.P$2 (2), R4.P$2 (2), R6.P$2 (2), R9.P$2 (2), R18.P$2 (2), R22.P$2 (2), R48.P$1 (1), R54.P$1 (1), R58.P$1 (1), R59.P$1 (1), R60.P$1 (1), R61.P$1 (1), U1.GND, U$1.1 (GND), U$1.2 (GND), U$1.47 (GND), U$1.48 (GND), U$1.89 (GND), U$1.90 (GND), U$1.91 (GND), U$1.92 (GND), ZENER.A
I2C_SCL: J15.3, U$1.70 (UART1_TXD)
I2C_SDA: J15.2, U$1.72 (UART1_RXD)
IN0: 0.2 (S), U$1.IN_PIN1 (1)
IN1: 1.2 (S), U$1.IN_PIN2 (2)
IN2: 2.2 (S), U$1.IN_PIN3 (3)
IN3: 3.2 (S), U$1.IN_PIN4 (4)
IN4: 4.2 (S), U$1.IN_PIN5 (5)
IN5: 5.2 (S), U$1.IN_PIN6 (6)
IN6: 6.2 (S), U$1.IN_PIN7 (7)
IN7: 7.2 (S), U$1.IN_PIN8 (8)
IN_COM: U$1.IN_PIN9 (9)
IN_GND: U$1.IN_PIN10 (10)
MUX1A: U$1.45 (GPIO2_6)
MUX1B: U$1.46 (GPIO2_7)
MUX1C: U$1.43 (GPIO2_8)
MUX2A: U$1.44 (GPIO2_9)
MUX2B: U$1.41 (GPIO2_10)
MUX2C: U$1.42 (GPIO2_11)
unnamed: J10.3, JACK_IN_6.P$1 (2)
unnamed: DZ1.6 (A), R26.P$2 (2)
unnamed: DZ1.7 (A), R27.P$2 (2)
unnamed: DZ1.8 (A), R28.P$2 (2)
unnamed: DZ1.9 (A), R29.P$2 (2)
unnamed: DZ1.10 (A), R30.P$2 (2)
unnamed: DZ1.5 (A), R31.P$2 (2)
unnamed: DZ1.4 (A), R32.P$2 (2)
unnamed: DZ1.3 (A), R33.P$2 (2)
unnamed: DZ1.2 (A), R34.P$2 (2)
unnamed: DZ1.1 (A), R35.P$2 (2)
unnamed: 1.1 (A), C3.2, R3.P$1 (1)
unnamed: J12.2, R23.P$2 (2)
unnamed: J11.3, JACK_IN_7.P$1 (2)
unnamed: 6.1 (A), C7.2, R21.P$1 (1)
unnamed: J9.2, R17.P$2 (2)
unnamed: 5.1 (A), C6.2, R19.P$1 (1)
unnamed: J9.3, JACK_IN_5.P$1 (2)
unnamed: J12.3, JACK_IN_8.P$1 (2)
unnamed: 4.1 (A), C5.2, R17.P$1 (1)
unnamed: J10.4, R13.P$1 (1)
unnamed: J12.4, R15.P$1 (1)
unnamed: J9.4, R11.P$1 (1)
unnamed: J10.2, R19.P$2 (2)
unnamed: J11.2, R21.P$2 (2)
unnamed: J11.4, R14.P$1 (1)
unnamed: C18.1, IC1.5 (+IN), R50.P$2 (2)
unnamed: J22.1, R24.P$2 (2)
unnamed: J17.1, JACK_IN_5.P$2 (3)
unnamed: JACK_OUT_1.P$1 (2), R36.P$2 (2)
unnamed: J19.1, JACK_IN_7.P$2 (3)
unnamed: J18.1, JACK_IN_6.P$2 (3)
unnamed: J20.1, JACK_IN_8.P$2 (3)
unnamed: JACK_OUT_2.P$1 (2), R37.P$2 (2)
unnamed: JACK_OUT_3.P$1 (2), R38.P$2 (2)
unnamed: JACK_OUT_4.P$1 (2), R39.P$2 (2)
unnamed: JACK_OUT_5.P$1 (2), R40.P$2 (2)
unnamed: JACK_OUT_6.P$1 (2), R41.P$2 (2)
unnamed: JACK_OUT_7.P$1 (2), R42.P$2 (2)
unnamed: JACK_OUT_8.P$1 (2), R43.P$2 (2)
unnamed: C11.1, IC1.3 (+IN), R44.P$2 (2)
unnamed: IC1.2 (-IN), R45.P$2 (2)
unnamed: C11.2, IC1.1 (OUT), R25.P$1 (1), R49.P$2 (2)
unnamed: IC1.6 (-IN), R51.P$2 (2)
unnamed: C12.2, C13.2, R44.P$1 (1), R45.P$1 (1), R46.P$2 (2), R47.P$2 (2), R48.P$2 (2), R49.P$1 (1)
unnamed: C16.2, C17.2, R50.P$1 (1), R51.P$1 (1), R52.P$2 (2), R53.P$2 (2), R54.P$2 (2), R55.P$1 (1)
unnamed: C18.2, IC1.7 (OUT), R56.P$1 (1)
unnamed: J21.1, R57.P$2 (2)
OUT0: R36.P$1 (1), U$1.OUT_PIN1 (1)
OUT1: R37.P$1 (1), U$1.OUT_PIN2 (2)
OUT2: R38.P$1 (1), U$1.OUT_PIN3 (3)
OUT3: R39.P$1 (1), U$1.OUT_PIN4 (4)
OUT4: R40.P$1 (1), U$1.OUT_PIN5 (5)
OUT5: R41.P$1 (1), U$1.OUT_PIN6 (6)
OUT6: R42.P$1 (1), U$1.OUT_PIN7 (7)
OUT7: R43.P$1 (1), U$1.OUT_PIN8 (8)
OUT_GND: U$1.OUT_PIN10 (10)
POT_IN1: 0.1 (A), C4.2, R12.P$1 (1)
POT_IN3: 2.1 (A), C2.2, R1.P$1 (1)
POT_IN4: 3.1 (A), C1.2, R5.P$1 (1)
POT_IN8: 7.1 (A), C8.2, R23.P$1 (1)
REG_5V: C9.2, C10.1 (+), D1.A, J14.1, U1.OUT
SYS_5V: U$1.53 (SYS_5V)
VOLTAGE_SELECT_OUTPUT: J9.1, J10.1, J11.1, J12.1, J16.2, J17.2, J18.2, J19.2, J20.2, JACK_IN_1.P$2 (3), JACK_IN_2.P$2 (3), JACK_IN_3.P$2 (3), JACK_IN_4.P$2 (3)
ZENER_10V: J16.3, R10.P$1 (1), ZENER.C

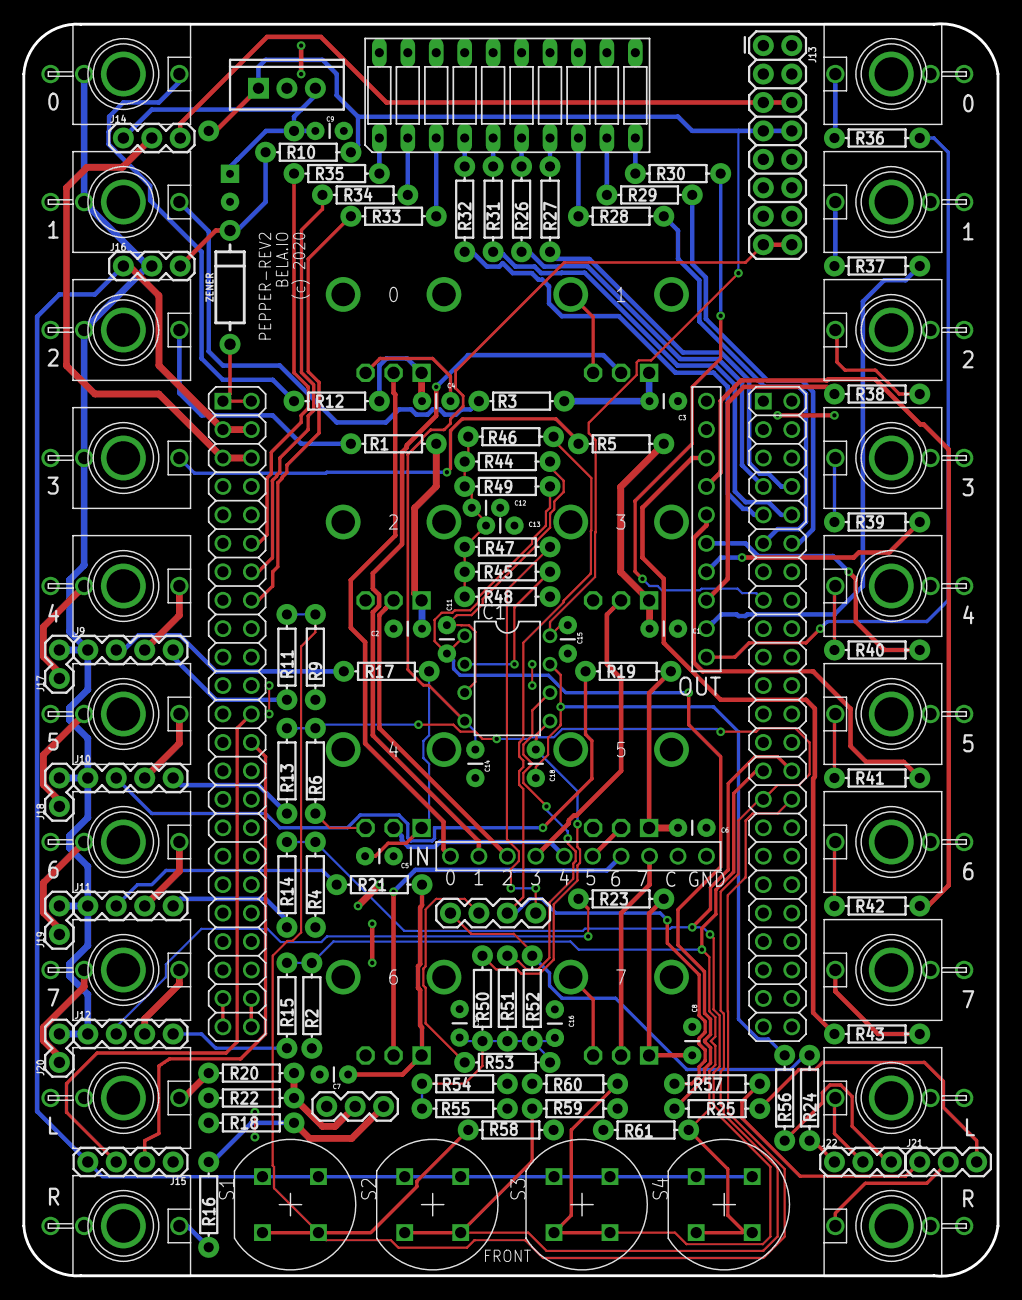
[picture p16: board pepper-rev2.brd from above]

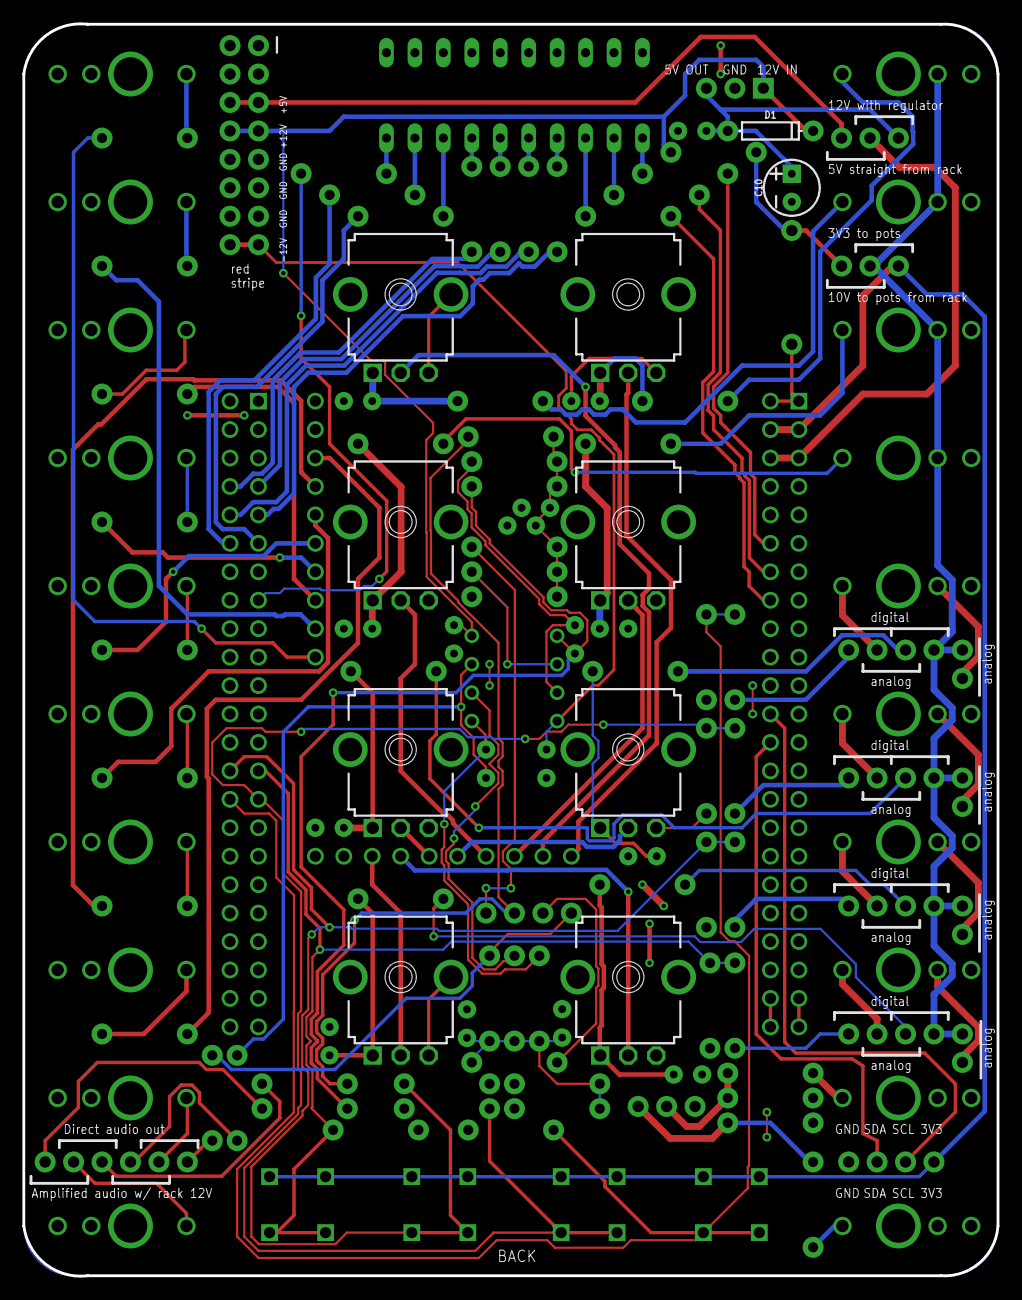
[picture p17: board pepper-rev2.brd from below]

Board: 2 copper layers, 87.0 x 111.8 mm, 131 parts (10 on the bottom side), 109 nets.
