BelaPlatform/bela-pepper/(commit log)

2019-07-02 Added schematic, board and faceplate and cleaned examples.
2022-09-14 Added design files
    [pepper-rev1.brd, pepper-rev1.sch, pepper-rev2.brd, pepper-rev2.sch, pepper-rev2b.brd, pepper-rev2b.sch]
2022-12-15 Added schematic 2b
