BelaPlatform/bela-pepper/(notices)

Notices in the files:
Design Files/rev1/pepper-rev1.brd:
BELA.IO (c) 2019
parts and their libraries:
SparkFun-Capacitors: Licensing: Creative Commons ShareAlike 4.0 International - https://creativecommons.org/licenses/by-sa/4.0
